collinthornton/ECEN4013Project2/KiCAD/ECEN4013_Project2_Team3_Invoice_JLCPCB.pdf

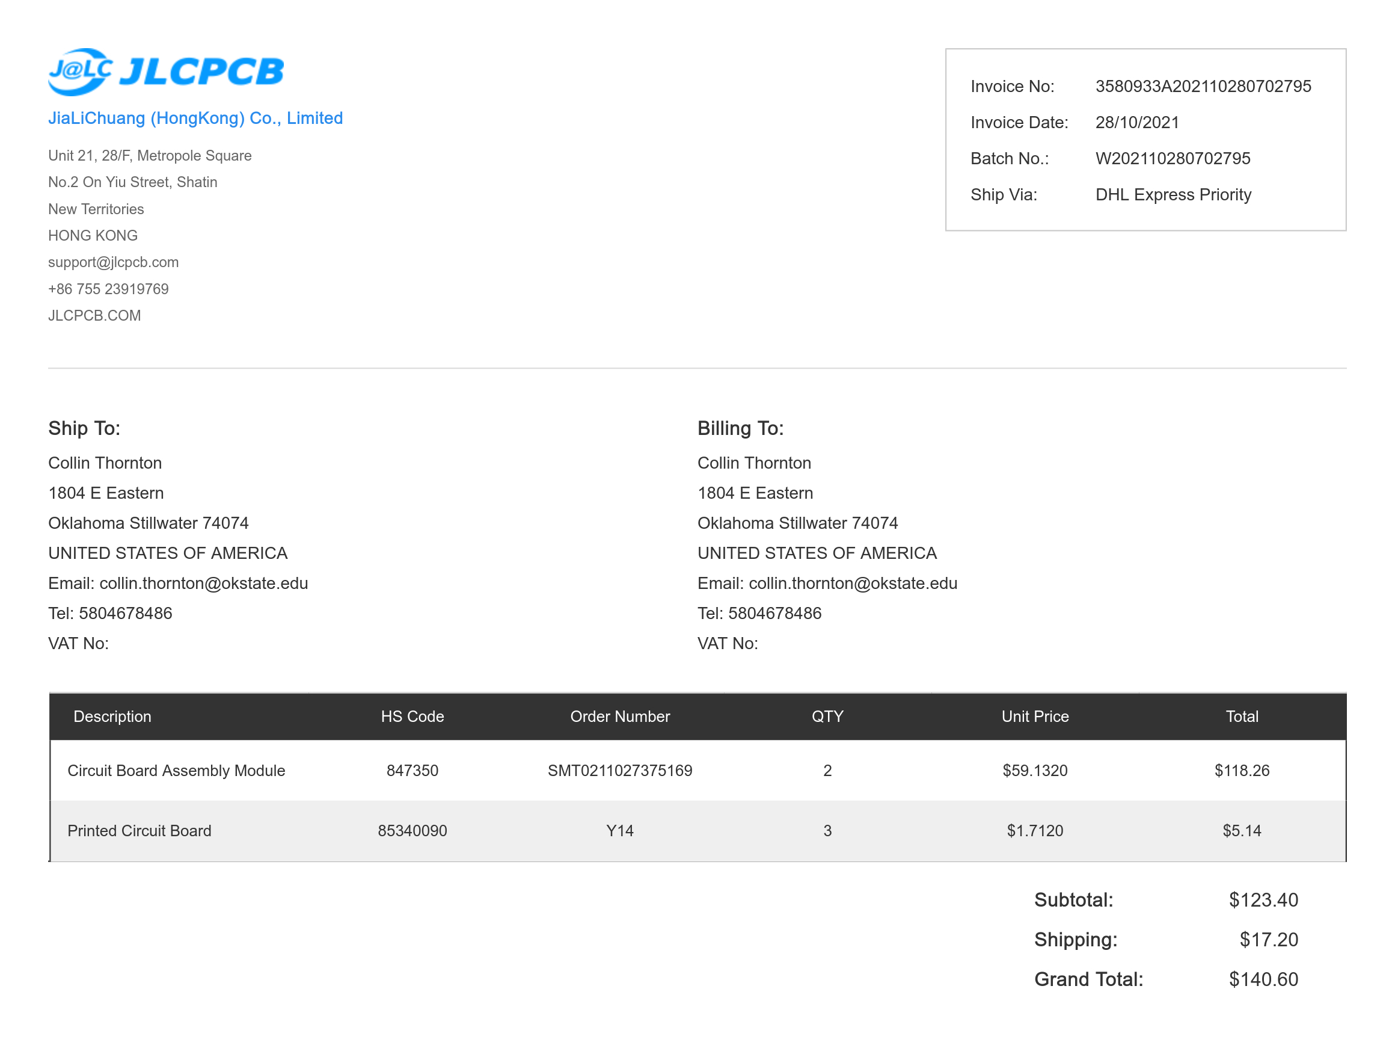
[picture p1: figure]
