collinthornton/ECEN4013Project2/KiCAD/needed_parts.xlsx

Designator | Comment | Footprint | Quantity | Mouser # | Link
U9 | MLX90393 | Package_DFN_QFN:QFN-16-1EP_5x5mm_P0.8mm_EP2.7x2.7mm | 1 | 482-90393ELWABA012RE | https://www.mouser.com/ProductDetail/Melexis/MLX90393ELW-ABA-012-RE
D5 | BATT_STAT | custom:APHF1608LSEEQBDZGKC | 1 | 604-APHF1608LQBDZGKC | https://www.mouser.com/ProductDetail/Kingbright/APHF1608LSEEQBDZGKC
SW1 | ON_OFF | Button_Switch_SMD:SW_DIP_SPSTx01_Slide_6.7x4.1mm_W8.61mm_P2.54mm_LowProfile | 1 | 490-DS04254101BK-SMT | https://www.mouser.com/ProductDetail/CUI-Devices/DS04-254-1-01BK-SMT?qs=wnTfsH77Xs40YtszDww4tg%3D%3D
J1 | USB_OTG | Connector_USB:USB_Micro-B_Molex_47346-0001 | 1 | 538-47346-0001 | https://www.mouser.com/ProductDetail/Molex/47346-0001?qs=sGAEpiMZZMtKBkH%252Brst%2F1jvgUDGkoG0c
