collinthornton/ECEN4013Project2/KiCAD/Board/Board.kicad_pcb

## KiCad design KiCAD/Board/Board.kicad_pcb (2021-12-07)

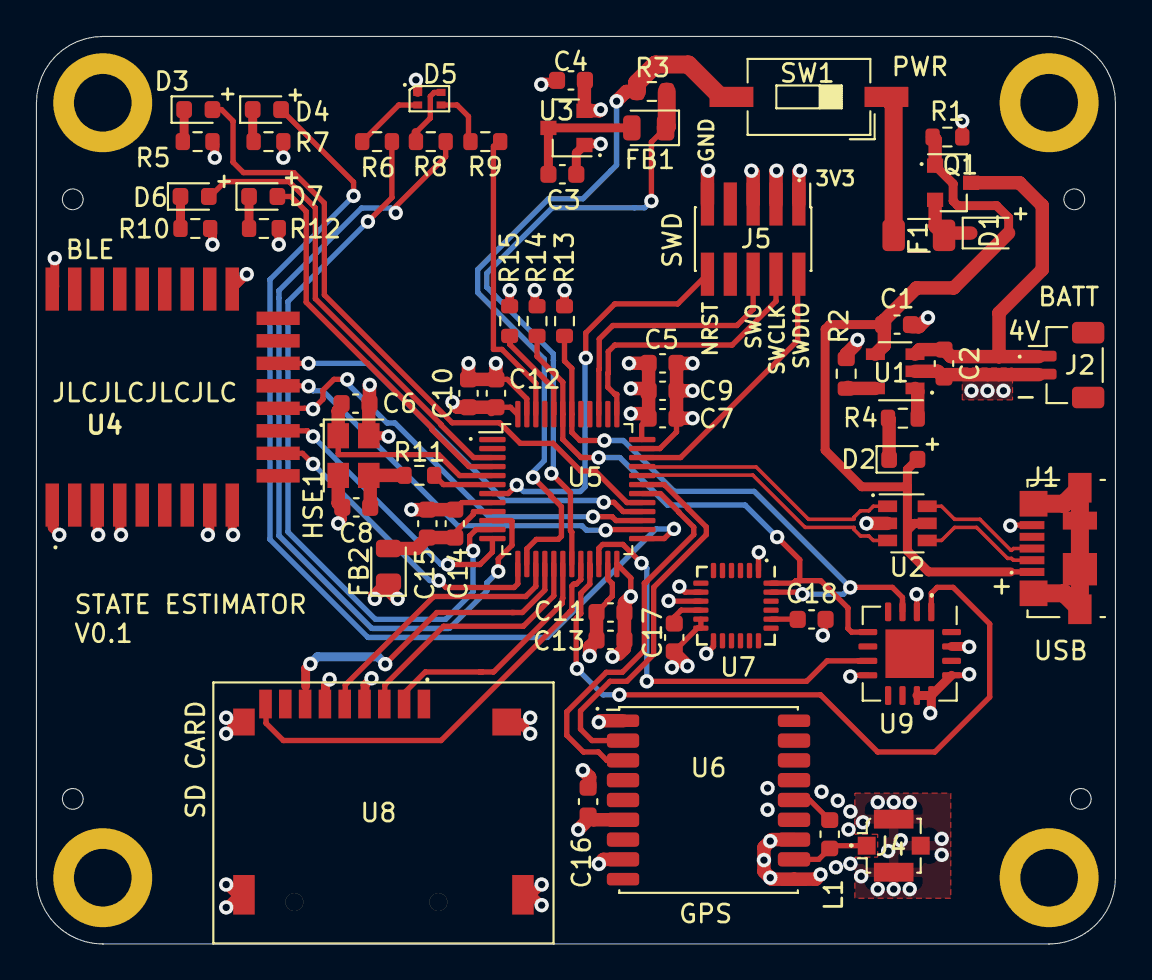
[picture p2: board Board.kicad_pcb from above]

Board: 4 copper layers, 59.9 x 50.4 mm, 64 parts (0 on the bottom side), 59 nets.

Parts:
C1, C2: 4.7uF; C_0603_1608Metric
C3, C4: 1u; C_0603_1608Metric
C5, C16: 10u; C_0603_1608Metric
C6, C8: 14pF; C_0603_1608Metric
C7, C9, C10, C11, C12, C13, C14: 100n; C_0603_1608Metric
C15: 10n; C_0603_1608Metric
C17: 0.1u; C_0603_1608Metric
C18: 2.2n; C_0603_1608Metric
D1: D_Schottky; D_SOD-323
D2: CHARGE_LED_R; LED_0603_1608Metric
D3: GPS_STATUS; LED_0603_1608Metric
D4: SD_ACT; LED_0603_1608Metric
D5: BATT_STAT; APHF1608LSEEQBDZGKC
D6: USB_ACT; LED_0603_1608Metric
D7: BLE_CON; LED_0603_1608Metric
F1: 500mA; Fuse_1206_3216Metric
FB1, FB2: 100 @ 100 MHz; D_0805_2012Metric
H1, H2, H3, H4: MountingHole_Pad; MountingHole_3.2mm_M3_ISO14580_Pad
HSE1: 24MHz; Crystal_SMD_3225-4Pin_3.2x2.5mm
J1: USB_OTG; USB_Micro-B_Molex_47346-0001
J2: JST_BATT; JST_SH_BM02B-SRSS-TB_1x02-1MP_P1.00mm_Vertical
J4: Conn_Coaxial; U.FL_Molex_MCRF_73412-0110_Vertical
J5: Conn_02x05_Odd_Even; PinHeader_2x05_P1.27mm_Vertical_SMD
L1: 27nH; L_0603_1608Metric
Q1: PWR_PMOS; SOT-23
R1, R15: 10k; R_0603_1608Metric
R2: 5k; R_0603_1608Metric
R3: 0.4; R_0603_1608Metric
R4: 470; R_0603_1608Metric
R5, R7, R10, R12: 10; R_0603_1608Metric
R6: 50; R_0603_1608Metric
R8, R9: 34; R_0603_1608Metric
R11: 220; R_0603_1608Metric
R13, R14: 2k2; R_0603_1608Metric
SW1: ON_OFF; SW_DIP_SPSTx01_Slide_6.7x4.1mm_W8.61mm_P2.54mm_LowProfile
U1: MCP73831-2-OT; SOT-23-5
U2: USBLC6-2SC6; SOT-23-6
U3: ME6211A28M3G-N; SOT-23
U4: DS-32-BLE4.2; DL-32-BLE4.2
U5: STM32L151C8TxA; LQFP-48_7x7mm_P0.5mm
U6: ATGM336H-1N; ublox_MAX
U7: MPU-6050; InvenSense_QFN-24_4x4mm_P0.5mm
U8: Micro_SD_TF-15; MICRO_SD_TF-15
U9: MLX90393; QFN-16-1EP_5x5mm_P0.8mm_EP2.7x2.7mm

Connections:
+3.3VA: C14.1, C15.1, FB2.2, U5.9
+3V3: C4.1, C5.1, C7.1, C9.1, C10.1, C11.1, C12.1, C13.1, C16.1, D5.1, FB2.1, J5.1, R13.1, R14.1, U3.2, U4.8, U5.24, U5.36, U5.48, U6.6, U6.8, U7.8, U7.13, U8.4, U9.2, U9.8, U9.15
+5V: C1.1, D1.2, D2.2, J1.1, Q1.1, R1.1, U1.4, U2.5
BLE_EN: U4.15, U5.28
BLE_INT: U4.14, U5.26
BLE_LED_G: D7.2, U5.4
BLE_STATUS: U4.13, U5.27
BOOT0: R15.1, U5.44
GND: C1.2, C2.2, C3.2, C4.2, C5.2, C6.2, C7.2, C8.2, C9.2, C10.2, C11.2, C12.2, C13.2, C14.2, C15.2, C16.2, C17.2, C18.2, H1.1, H2.1, H3.1, H4.1, HSE1.2, HSE1.4, J1.5, J2.2, J4.2, J5.3, J5.5, J5.9, R1.2, R2.2, R5.2, R7.2, R10.2, R12.2, R15.2, U1.2, U2.2, U3.1, U4.1, U4.3, U4.4, U4.9, U4.18, U4.26, U5.8, U5.23, U5.35, U5.47, U6.1, U6.10, U6.12, U7.1, U7.9, U7.11, U7.12, U8.6, U9.11, U9.12, U9.13
GPS_LED_G: D3.2, U5.29
HSE_IN: C6.1, HSE1.1, U5.5
HSE_OUT: R11.1, U5.6
I2C1_SCL: R13.2, U5.42, U7.23, U9.3
I2C1_SDA: R14.2, U5.43, U7.24, U9.5
MLX_RDY: U5.21, U9.1
MLX_TRIG: U5.22, U9.7
NRST: J5.10, U5.7
unnamed: C3.1, FB1.2, U3.3
unnamed: C8.1, HSE1.3, R11.2
unnamed: C17.1, U7.10
unnamed: C18.1, U7.20
unnamed: D1.1, F1.2, Q1.2
unnamed: D2.1, R4.2
unnamed: D3.1, R5.1
unnamed: D4.1, R7.1
unnamed: D5.2, R6.1
unnamed: D5.3, R9.1
unnamed: D5.4, R8.1
unnamed: D6.1, R10.1
unnamed: D7.1, R12.1
unnamed: F1.1, SW1.1
unnamed: J4.1, L1.1, U6.11
unnamed: L1.2, U6.14
unnamed: R2.1, U1.5
unnamed: R4.1, U1.1
PWR_LED_B: R9.2, U5.46
PWR_LED_G: R8.2, U5.10
PWR_LED_R: R6.2, U5.11
SD_DETECT: U5.20, U8.9
SD_LED_G: D4.2, U5.25
SPI1_MISO: U5.16, U8.7
SPI1_MOSI: U5.17, U8.3
SPI1_SCK: U5.15, U8.5
SPI_CS_SD: U5.18, U8.2
SWCLK: J5.4, U5.37
SWDIO: J5.2, U5.34
SWO: J5.6, U5.39
UART1_RX: U5.31, U6.2
UART1_TX: U5.30, U6.3
UART2_RX: U4.11, U5.13
UART2_TX: U4.12, U5.12
USB_CONN_D+: J1.3, U2.6
USB_CONN_D-: J1.2, U2.4
USB_D+: U2.1, U5.33
USB_D-: U2.3, U5.32
USB_LED_G: D6.2, U5.3
V_BAT: C2.1, J2.1, Q1.3, U1.3
V_BAT_M: FB1.1, R3.1, U5.19
V_BAT_P: R3.2, SW1.2, U5.14
