collinthornton/ECEN4013Project2/EmbeddedCode/CustomBoard/Core/Src/main.cpp

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
/* Includes ------------------------------------------------------------------*/
#include <main.h>
#include "fatfs.h"
#include "usb_device.h"


/* USER CODE BEGIN Includes */
#include "usbd_cdc_if.h"
#include "UART.h"
#include "string.h"
#include "stdlib.h"
#include "stdio.h"
#include "stdarg.h"
#include <math.h>
#include <mpu6050.h>

#define SD_TIMER_HANDLE htim6
#define BLE_TIMER_HANDLE htim7
/* USER CODE END Includes */

/* USER CODE BEGIN PD */
extern Disk_drvTypeDef  disk;

uint8_t usbBuffer[16];

enum SDSTATE {
	DISCONNECTED,
	CONNECTED,
	MOUNTED,
	FILE_OPEN
};
SDSTATE sdState;
volatile uint8_t sdCount=0, sdOverlap=15;

typedef struct {
	uint16_t UTC_Hour;
	uint16_t UTC_Min;
	uint16_t UTC_Sec;
	uint16_t UTC_MicroSec;

	float	Latitude;
	double  LatitudeDecimal;
	char	NS_Indicator;

	float	Longitude;
	double 	LongitudeDecimal;
	char	EW_Indicator;

	uint16_t	PositionFixIndicator;
	uint16_t	SatellitesUsed;
	float	HDOP;
	float	MSL_Altitude;
	char	MSL_Units;
	float	Geoid_Separation;
	char	Geoid_Units;

	uint16_t	AgeofDiffCorr;
	char	DiffRefStationID[4];
	char	CheckSum[2];


} GPGGA;
/* USER CODE END PD */

ADC_HandleTypeDef hadc;
DMA_HandleTypeDef hdma_adc;

I2C_HandleTypeDef hi2c1;

SPI_HandleTypeDef hspi1;

TIM_HandleTypeDef htim6;
TIM_HandleTypeDef htim7;

UART_HandleTypeDef huart1;
UART_HandleTypeDef huart2;

/* USER CODE BEGIN PV */
UART gps(&huart1), ble(&huart2);
MPU6050_t mpu6050;

uint32_t adcValue[2];
/* USER CODE END PV */

void SystemClock_Config(void);
static void MX_GPIO_Init(void);
static void MX_ADC_Init(void);
static void MX_I2C1_Init(void);
static void MX_SPI1_Init(void);
static void MX_DMA_Init(void);
static void MX_TIM6_Init(void);
static void MX_TIM7_Init(void);
/* USER CODE BEGIN PFP */
double convertDegMinToDecDeg (float degMin);
/* USER CODE END PFP */

/**
  * @brief  The application entry point.
  * @retval int
  */
int main(void)
{
  /* MCU Configuration--------------------------------------------------------*/

  /* Reset of all peripherals, Initializes the Flash interface and the Systick. */
  HAL_Init();

  /* USER CODE BEGIN Init */
  GPGGA gpsData;
  /* USER CODE END Init */

  /* Configure the system clock */
  SystemClock_Config();

  /* Initialize all configured peripherals */
  MX_GPIO_Init();
  MX_ADC_Init();
  MX_I2C1_Init();
  MX_SPI1_Init();
  MX_FATFS_Init();
  MX_DMA_Init();
  MX_USB_DEVICE_Init();
  MX_TIM6_Init();
  MX_TIM7_Init();
  /* USER CODE BEGIN 2 */
  HAL_ADC_Start_DMA(&hadc, adcValue, 2);

  // Setup UART devices at 9600 baud
  ble.init(USART2, 9600, 1);
  gps.init(USART1, 9600, 1);

  MPU6050_Init(&hi2c1);

  memset(&gpsData,0,sizeof(gpsData));
  gpsData.LatitudeDecimal = 0.0;
  gpsData.LongitudeDecimal = 0.0;
  if(gpsData.NS_Indicator==0)
	  gpsData.NS_Indicator='-';
  if(gpsData.EW_Indicator==0)
	  gpsData.EW_Indicator='-';
  if(gpsData.Geoid_Units==0)
	  gpsData.Geoid_Units='-';
  if(gpsData.MSL_Units==0)
	  gpsData.MSL_Units='-';

  /* USER CODE END 2 */

  /* Infinite loop */
  /* USER CODE BEGIN WHILE */
  uint8_t buff[1024] = {0};
  char msg[100] = {0};

  uint32_t elapsedTime = 0;
  uint32_t prevTime = HAL_GetTick();

  HAL_GPIO_WritePin(BLE_EN_GPIO_Port, BLE_EN_Pin, GPIO_PIN_SET);

  HAL_Delay(1000);


  FATFS FatFS;

  FIL fil;
  FRESULT fres;


  // Check SD card detect pin and attemp to mount/dismount file system accordingly
  GPIO_PinState sdValue = HAL_GPIO_ReadPin(SD_DETECT_GPIO_Port, SD_DETECT_Pin);

  if(sdValue == GPIO_PIN_SET) {
	 if(sdState == FILE_OPEN) {
		 f_close(&fil);
		 sdState = MOUNTED;
	 }
	 if(sdState == MOUNTED) {
		 f_mount(NULL, "", 1);
	 }

	 disk.is_initialized[0] = 0;
	 sdState = DISCONNECTED;
	}
	else if(sdValue == GPIO_PIN_RESET) {
	  fres = f_mount(&FatFS, "", 1);
	  if(fres != FR_OK) {
		  sprintf((char*)buff, "f_mount error (%i)\r\n", fres);
		  CDC_Transmit_FS(buff, strlen((char*)buff));
		  ble.sendData(buff, strlen((char*)buff));
		  sdState = CONNECTED;
	  }
	  else {
		  sdState = MOUNTED;
	  }
  }


  // Setup timer IRQ
  HAL_TIM_Base_Start_IT(&SD_TIMER_HANDLE);
  HAL_TIM_Base_Start_IT(&BLE_TIMER_HANDLE);


  // Make CSV header
  sprintf((char*)buff,
    "UTC Time, Loop Time, Lat (Deg), NS, Long. (Deg), EW, MSL Alt., Units, Sats., ax (m/s^2), ay (m/s^2), az (m/s^2), gx (deg/s), gy (deg/s), gz (deg/s)\r\n"
  );

  // Transmit CSV header over USB and BLE
  CDC_Transmit_FS(buff, strlen((char*)buff));
  ble.sendData(buff, strlen((char*)buff), 50000);


  // Attempt to open file and write CSV header to SD card
  if(sdState == MOUNTED) {
	  fres = f_open(&fil, "log.csv", FA_CREATE_ALWAYS | FA_WRITE | FA_READ);
	  if(fres != FR_OK) {
		  sprintf((char*)buff, "f_open error (%i)\r\n", fres);
		  CDC_Transmit_FS(buff, strlen((char*)buff));
		  ble.sendData(buff, strlen((char*)buff));
	  }
	  else {
		  sdState = FILE_OPEN;
		  UINT bytesWrote;

		  if(f_write(&fil, buff, strlen((char*)buff), &bytesWrote) != FR_OK) {
			  sprintf((char*)buff, "f_write error (%i)\r\n", fres);
			  CDC_Transmit_FS(buff, strlen((char*)buff));
			  ble.sendData(buff, strlen((char*)buff));
			  //while(1);
		  }
		  	  f_close(&fil);
		  	  sdState = MOUNTED;
	  }
  }


  while (1)
  {

	  // Get a line from the GPS buffer if available
	  if(gps.readLine(buff, sizeof(buff))) {

		  // Check for the GNGGA message
		  char *str = strstr((char*)buff, "$GNGGA,");
		  if(str!=NULL)
		  {
			  // Parse if available
			  memset(&gpsData,0,sizeof(gpsData));
			  sscanf(str,"$GNGGA,%2hu%2hu%2hu.%3hu,%f,%c,%f,%c,%hu,%hu,%f,%f,%c,%f,%c,,*%2s",
					  &gpsData.UTC_Hour,&gpsData.UTC_Min,&gpsData.UTC_Sec,&gpsData.UTC_MicroSec,&gpsData.Latitude,
					  &gpsData.NS_Indicator,&gpsData.Longitude,&gpsData.EW_Indicator,&gpsData.PositionFixIndicator,
					  &gpsData.SatellitesUsed,&gpsData.HDOP,&gpsData.MSL_Altitude,&gpsData.MSL_Units,&gpsData.Geoid_Separation,
					  &gpsData.Geoid_Units,gpsData.CheckSum);

			  if(gpsData.NS_Indicator==0)
				  gpsData.NS_Indicator='-';
			  if(gpsData.EW_Indicator==0)
				  gpsData.EW_Indicator='-';
			  if(gpsData.Geoid_Units==0)
				  gpsData.Geoid_Units='-';
			  if(gpsData.MSL_Units==0)
				  gpsData.MSL_Units='-';

			  gpsData.LatitudeDecimal=convertDegMinToDecDeg(gpsData.Latitude);
			  gpsData.LongitudeDecimal=convertDegMinToDecDeg(gpsData.Longitude);

			  // Set status LED
			  if(gpsData.SatellitesUsed > 3) HAL_GPIO_WritePin(GPS_LED_G_GPIO_Port, GPS_LED_G_Pin, GPIO_PIN_SET);
			  else HAL_GPIO_WritePin(GPS_LED_G_GPIO_Port, GPS_LED_G_Pin, GPIO_PIN_RESET);

			  memset(buff, '\0', sizeof(buff));
		  }
	  }


	 // Check value of SD chip detect pin and mount/dismount file system as necessary
	 GPIO_PinState sdValue = HAL_GPIO_ReadPin(SD_DETECT_GPIO_Port, SD_DETECT_Pin);

	 if(sdValue == GPIO_PIN_SET) {
		 if(sdState == FILE_OPEN) {
			 f_close(&fil);
			 sdState = MOUNTED;
		 }
		 if(sdState == MOUNTED) {
			 f_mount(NULL, "", 1);
		 }

		 disk.is_initialized[0] = 0;
		 sdState = DISCONNECTED;
	 }
	 else if(sdValue == GPIO_PIN_RESET && sdState == DISCONNECTED) {

		  fres = f_mount(&FatFS, "", 1);
		  if(fres != FR_OK) {
			  sprintf((char*)buff, "f_mount error (%i)\r\n", fres);
			  CDC_Transmit_FS(buff, strlen((char*)buff));
			  ble.sendData(buff, strlen((char*)buff));
			  sdState = CONNECTED;
		  }
		  else {
			  sdState = MOUNTED;
		  }
	 }


	  // Update IMU
	  MPU6050_Read_All(&hi2c1, &mpu6050);


	  // Format output string
	  sprintf((char*)buff,
			  "%hu:%hu:%hu,%ld,%.5f,%c,%.5f,%c,%.1f,%c,%d,%.3f,%.3f,%.3f,%.3f,%.3f,%.3f\r\n",

			  gpsData.UTC_Hour, gpsData.UTC_Min, gpsData.UTC_Sec, elapsedTime,
			  gpsData.LatitudeDecimal, gpsData.NS_Indicator, gpsData.LongitudeDecimal, gpsData.EW_Indicator,
			  gpsData.MSL_Altitude, gpsData.MSL_Units, gpsData.SatellitesUsed,
	 	mpu6050.Ax, mpu6050.Ay, mpu6050.Az,
		mpu6050.Gx, mpu6050.Gy, mpu6050.Gz
	  );


	  // Transmit output string via USB and BLE
	  CDC_Transmit_FS(buff, strlen((char*)buff));
	  ble.sendData(buff, strlen((char*)buff), 50000);


	  // Attempt to open file and write output string to SD card
	  if(sdState == MOUNTED) {
		  fres = f_open(&fil, "log.csv", FA_OPEN_APPEND | FA_WRITE | FA_READ);
		  if(fres != FR_OK) {
			  sprintf((char*)buff, "f_open error (%i)\r\n", fres);
			  CDC_Transmit_FS(buff, strlen((char*)buff));
			  ble.sendData(buff, strlen((char*)buff));
		  }
		  else {
			  sdState = FILE_OPEN;

			  UINT bytesWrote;
			  fres = f_write(&fil, buff, strlen((char*)buff), &bytesWrote);
			  if(fres != FR_OK) {
				  sprintf((char*)buff, "f_write error (%i)\r\n", fres);
				  CDC_Transmit_FS(buff, strlen((char*)buff));
				  ble.sendData(buff, strlen((char*)buff));
			  }
			  f_close(&fil);

			  sdState = MOUNTED;
		  }
	  }

	  // Compute elapsed time
	  elapsedTime = HAL_GetTick() - prevTime;
	  prevTime = HAL_GetTick();

	  HAL_Delay(900);
    /* USER CODE END WHILE */

    /* USER CODE BEGIN 3 */
  }
  f_mount(NULL, "", 0);
  /* USER CODE END 3 */
}


void HAL_TIM_PeriodElapsedCallback(TIM_HandleTypeDef *htim) {
    if (htim->Instance == TIM11) {
    	HAL_IncTick();
    }
    else if(htim->Instance == BLE_TIMER_HANDLE.Instance) {
    	GPIO_PinState bleState = HAL_GPIO_ReadPin(BLE_STATUS_GPIO_Port, BLE_STATUS_Pin);
		if(bleState == GPIO_PIN_RESET) {
			HAL_GPIO_TogglePin(BLE_LED_G_GPIO_Port, BLE_LED_G_Pin);
		}
		else {
			HAL_GPIO_WritePin(BLE_LED_G_GPIO_Port, BLE_LED_G_Pin, GPIO_PIN_RESET);
		}
	}
	else if(htim->Instance == SD_TIMER_HANDLE.Instance) {
		switch(sdState) {
		case DISCONNECTED:
			HAL_GPIO_WritePin(SD_LED_G_GPIO_Port, SD_LED_G_Pin, GPIO_PIN_RESET);
			sdCount = 0;
			break;

		case CONNECTED:
			HAL_GPIO_WritePin(SD_LED_G_GPIO_Port, SD_LED_G_Pin, GPIO_PIN_SET);
			sdCount = 0;
			break;

		case MOUNTED:
			if(++sdCount >= sdOverlap) {
				HAL_GPIO_TogglePin(SD_LED_G_GPIO_Port, SD_LED_G_Pin);
				sdCount = 0;
			}
			break;

		case FILE_OPEN:
			HAL_GPIO_TogglePin(SD_LED_G_GPIO_Port, SD_LED_G_Pin);
			sdCount = 0;
			break;
		}
	}
}

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
/* USER CODE BEGIN 4 */
void HAL_UART_RxCpltCallback(UART_HandleTypeDef *huart) {
	std::map<USART_TypeDef*, UART*>::iterator it;
	it = UART::objectMap.find(huart->Instance);
	if(it != UART::objectMap.end())
		it->second->memberIRQ();
}

double convertDegMinToDecDeg (float degMin)
{
  double min = 0.0;
  double decDeg = 0.0;

  //get the minutes, fmod() requires double
  min = fmod((double)degMin, 100.0);

  //rebuild coordinates in decimal degrees
  degMin = (int) ( degMin / 100 );
  decDeg = degMin + ( min / 60 );

  return decDeg;
}
/* USER CODE END 4 */
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
