collinthornton/ECEN4013Project2/EmbeddedCode/CustomBoard/CustomBoard.ioc

Mcu.UserName=STM32L151CBTx
PA0-WKUP1.GPIO_Label=PWR_LED_G
PA0-WKUP1.Signal=GPIO_Output
PA1.GPIO_Label=PWR_LED_R
PA1.Signal=GPIO_Output
PA10.Signal=USART1_RX
PA11.Signal=USB_DM
PA12.Signal=USB_DP
PA13.Signal=SYS_JTMS-SWDIO
PA14.Signal=SYS_JTCK-SWCLK
PA2.Signal=USART2_TX
PA3.Signal=USART2_RX
PA4.GPIO_Label=V_BAT_P
PA4.Signal=SharedAnalog_PA4
PA5.Signal=SPI1_SCK
PA6.Signal=SPI1_MISO
PA7.Signal=SPI1_MOSI
PA8.GPIO_Label=GPS_LED_G
PA8.Signal=GPIO_Output
PA9.Signal=USART1_TX
PB0.GPIO_Label=SPI_SD_CS
PB0.Signal=GPIO_Output
PB1.GPIO_Label=V_BAT_M
PB1.Signal=SharedAnalog_PB1
PB10.GPIO_Label=MLX_RDY
PB10.Signal=GPIO_Input
PB11.GPIO_Label=MLX_TRIG
PB11.Signal=GPIO_Output
PB12.GPIO_Label=SD_LED_G
PB12.Signal=GPIO_Output
PB13.GPIO_Label=BLE_INT
PB13.Signal=GPIO_Input
PB14.GPIO_Label=BLE_STATUS
PB14.Signal=GPIO_Output
PB15.GPIO_Label=BLE_EN
PB15.Signal=GPIO_Output
PB2.GPIO_Label=SD_DETECT
PB2.Signal=GPIO_Input
PB3.Signal=SYS_JTDO-TRACESWO
PB6.Signal=I2C1_SCL
PB7.Signal=I2C1_SDA
PB9.GPIO_Label=PWR_LED_B
PB9.Signal=GPIO_Output
PC14-OSC32_IN.GPIO_Label=USB_LED_G
PC14-OSC32_IN.Signal=GPIO_Output
PC15-OSC32_OUT.GPIO_Label=BLE_LED_G
PC15-OSC32_OUT.Signal=GPIO_Output
PH0-OSC_IN.Signal=RCC_OSC_IN
PH1-OSC_OUT.Signal=RCC_OSC_OUT
