collinthornton/ECEN4013Project2/(commit log)

2021-10-25 major update. schematic near complete. began working on backup code
    [Board-B_Cu.gbl, Board-B_Mask.gbs, Board-B_Paste.gbp, Board-B_SilkS.gbo, Board-Edge_Cuts.gm1, Board-F_Cu.gtl, Board-F_Mask.gts, Board-F_Paste.gtp]
2021-10-26 initialized backup project code
    [Board.kicad_pcb, Board.sch, Board_bom_bot.csv, Board_bom_top.csv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]
2021-10-28 submitted board to JLCPCB
    [Board-B_Cu.gbl, Board-B_Mask.gbs, Board-B_Paste.gbp, Board-B_SilkS.gbo, Board-Edge_Cuts.gm1, Board-F_Cu.gtl, Board-F_Mask.gts, Board-F_Paste.gtp]
2021-11-04 finished backup board startup backup code
    [Backup-B_Cu.gbr, Backup-B_Mask.gbr, Backup-B_Paste.gbr, Backup-B_SilkS.gbr, Backup-Edge_Cuts.gbr, Backup-F_Cu.gbr, Backup-F_Mask.gbr, Backup-F_Paste.gbr]
2021-11-04 added i2c
2021-11-04 began working on uart
2021-11-04 update uart class
    [Backup-B_Cu.gbr, Backup-B_Mask.gbr, Backup-B_Paste.gbr, Backup-B_SilkS.gbr, Backup-Edge_Cuts.gbr, Backup-F_Cu.gbr, Backup-F_Mask.gbr, Backup-F_Paste.gbr]
2021-11-04 updated uart class
2021-11-05 updates to uart
2021-11-05 uart working well
2021-11-05 bluetooth and usb working asynchronously. note that usb protocol will need to be implemented on real board
2021-11-09 began developing code for custom board
2021-11-09 working on uart
2021-11-11 gps working. mpu6050 responding, but bad values. ble responding to at commands, not connecting to wireless
    [Backup.kicad_pcb]
2021-12-07 final push
    [Board.kicad_pcb, Board.sch]
2021-12-09 replaced board sch with the backup-sh
    [Board.sch]
